vamshin24/bioinspired_grasshopper_jumping_mechanism/docs/notebooks/kinematics.pdf

Group 8 Project Assignment 1 | 14

## Kinematic Model

Jacobian Calculations 4 Bar JupyterLab

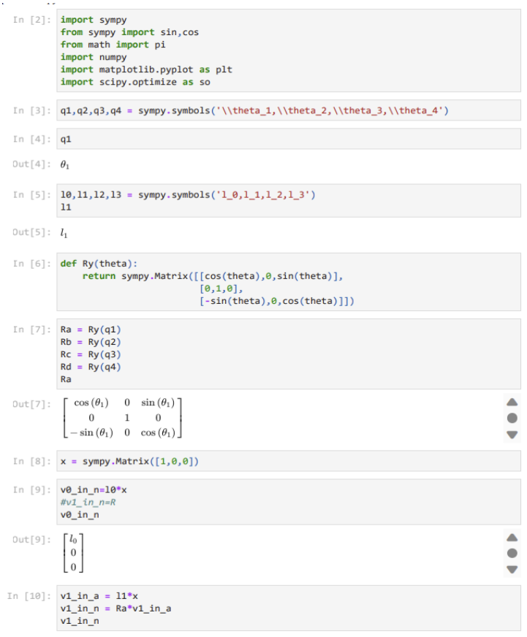
[picture p34: figure]
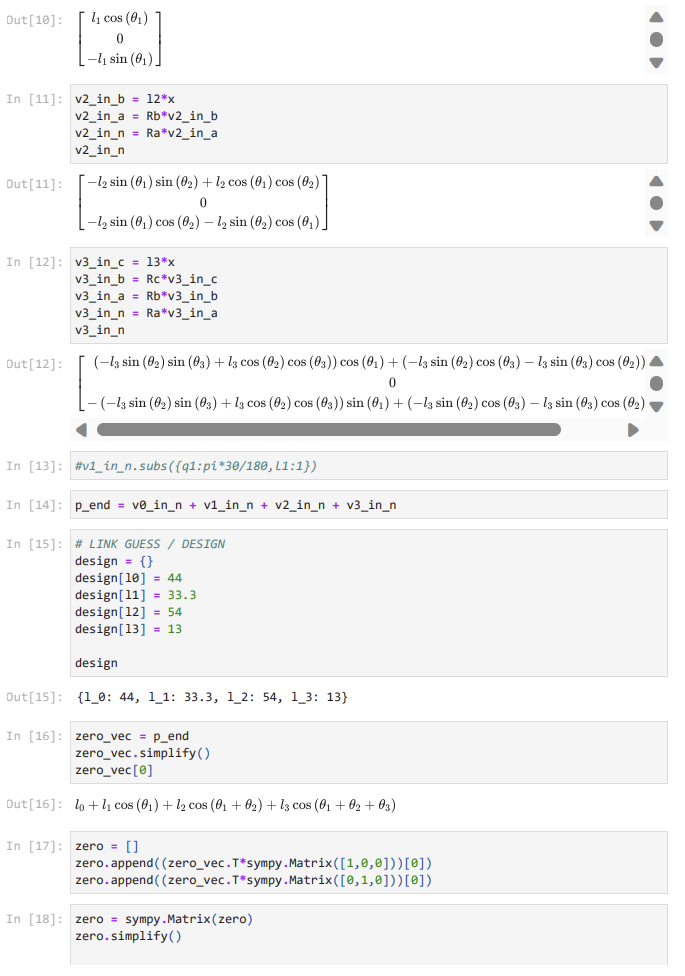
[picture p35: page 2]
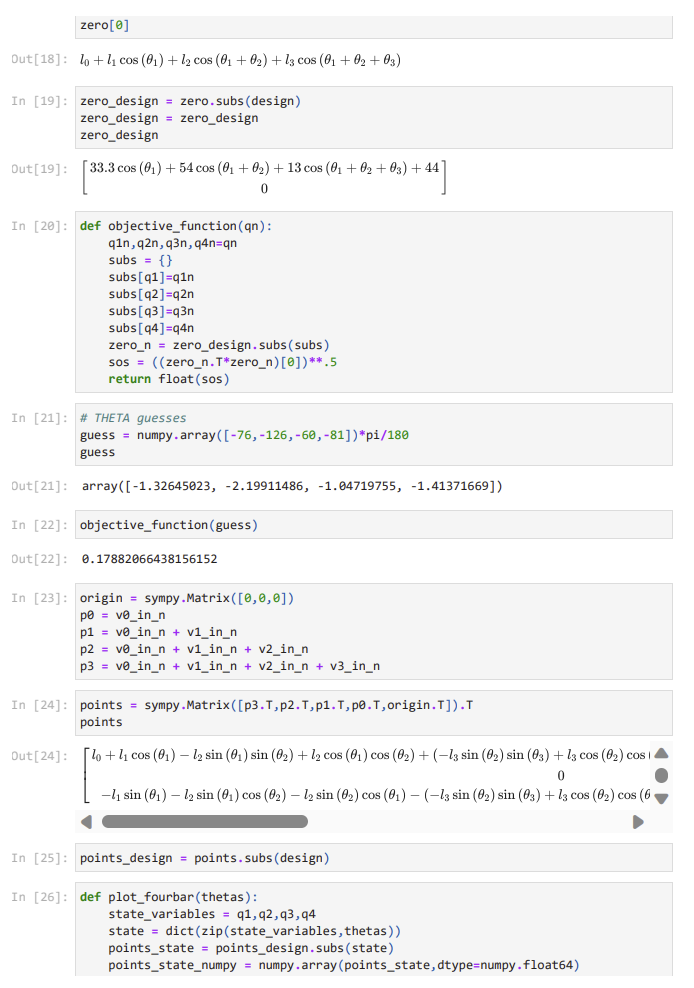
[picture p36: page 3]
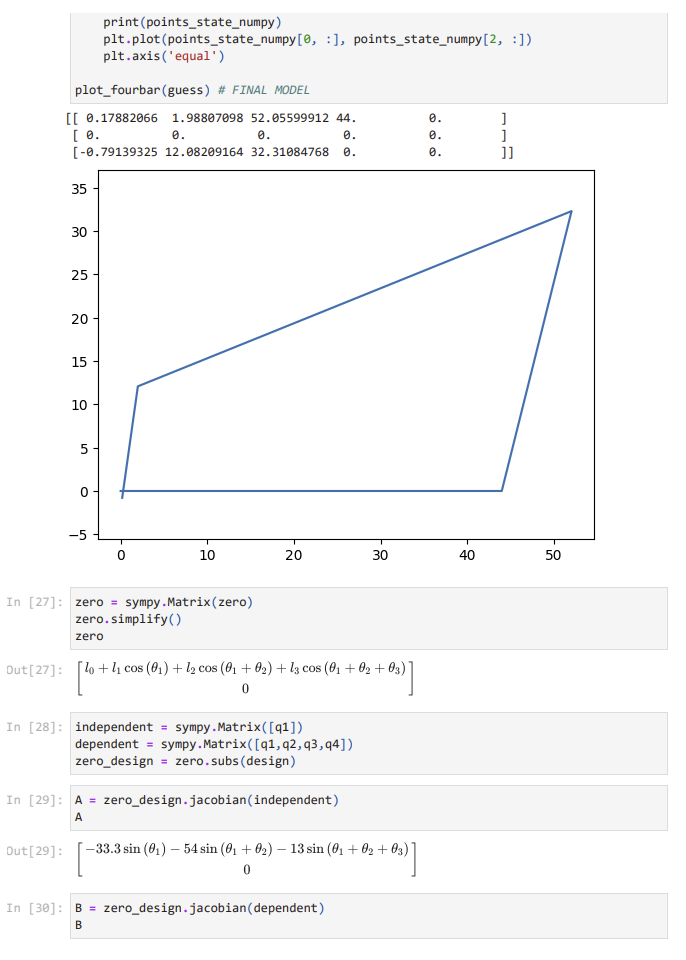
[picture p37: page 4]
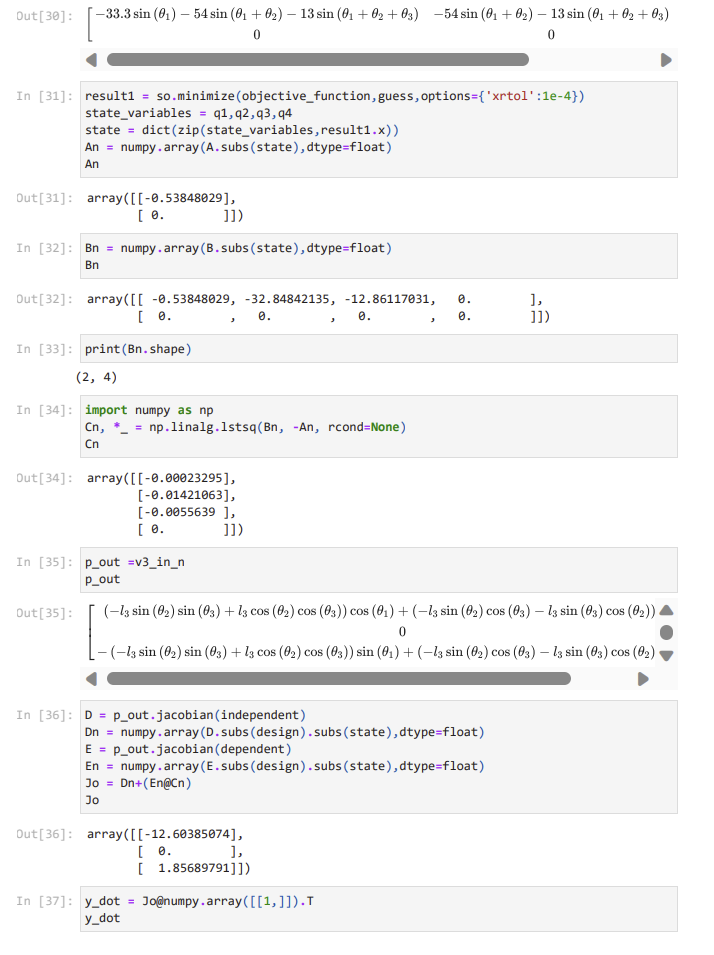
[picture p38: page 5]
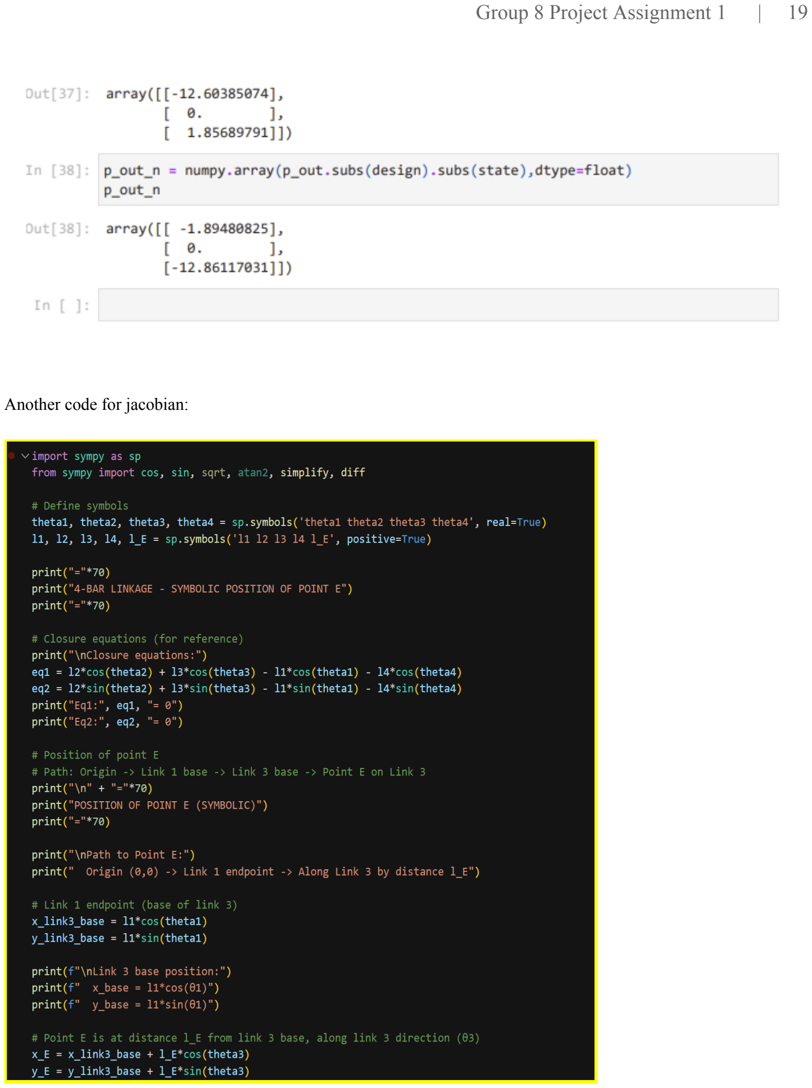
[picture p39: page 6]

Another code for jacobian:

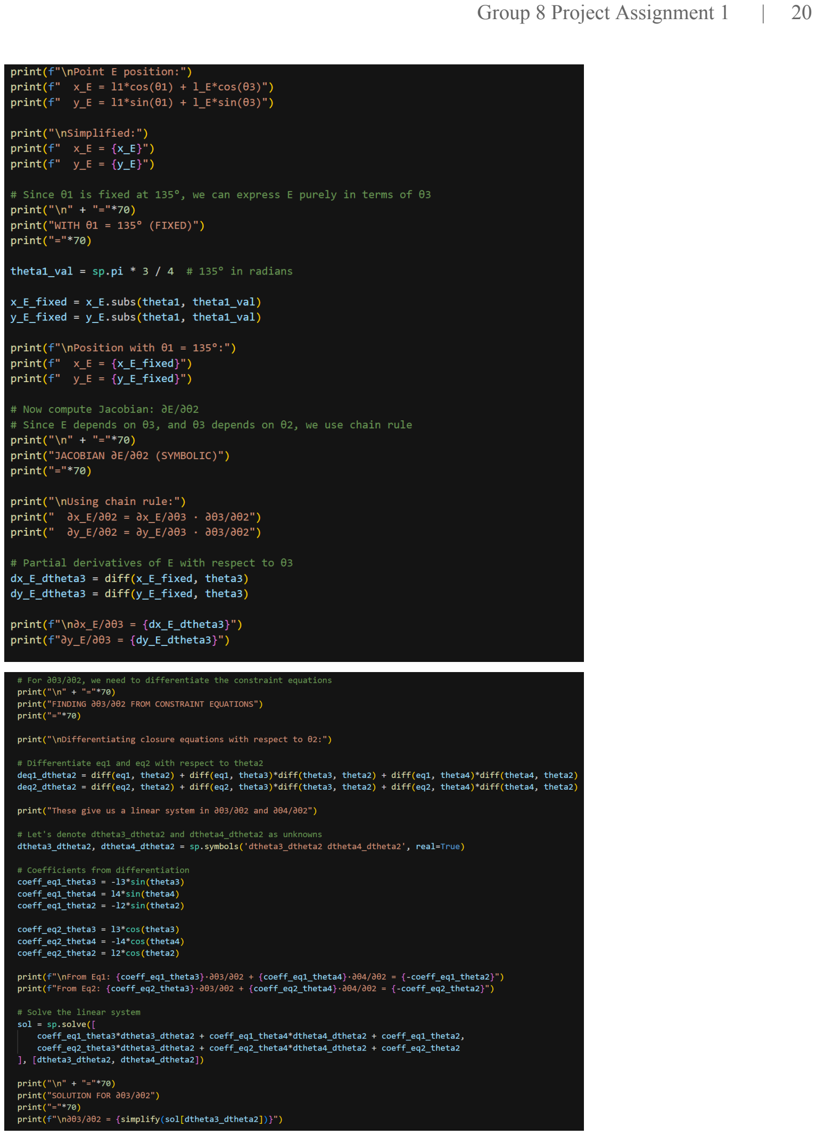
[picture p40: page 7]
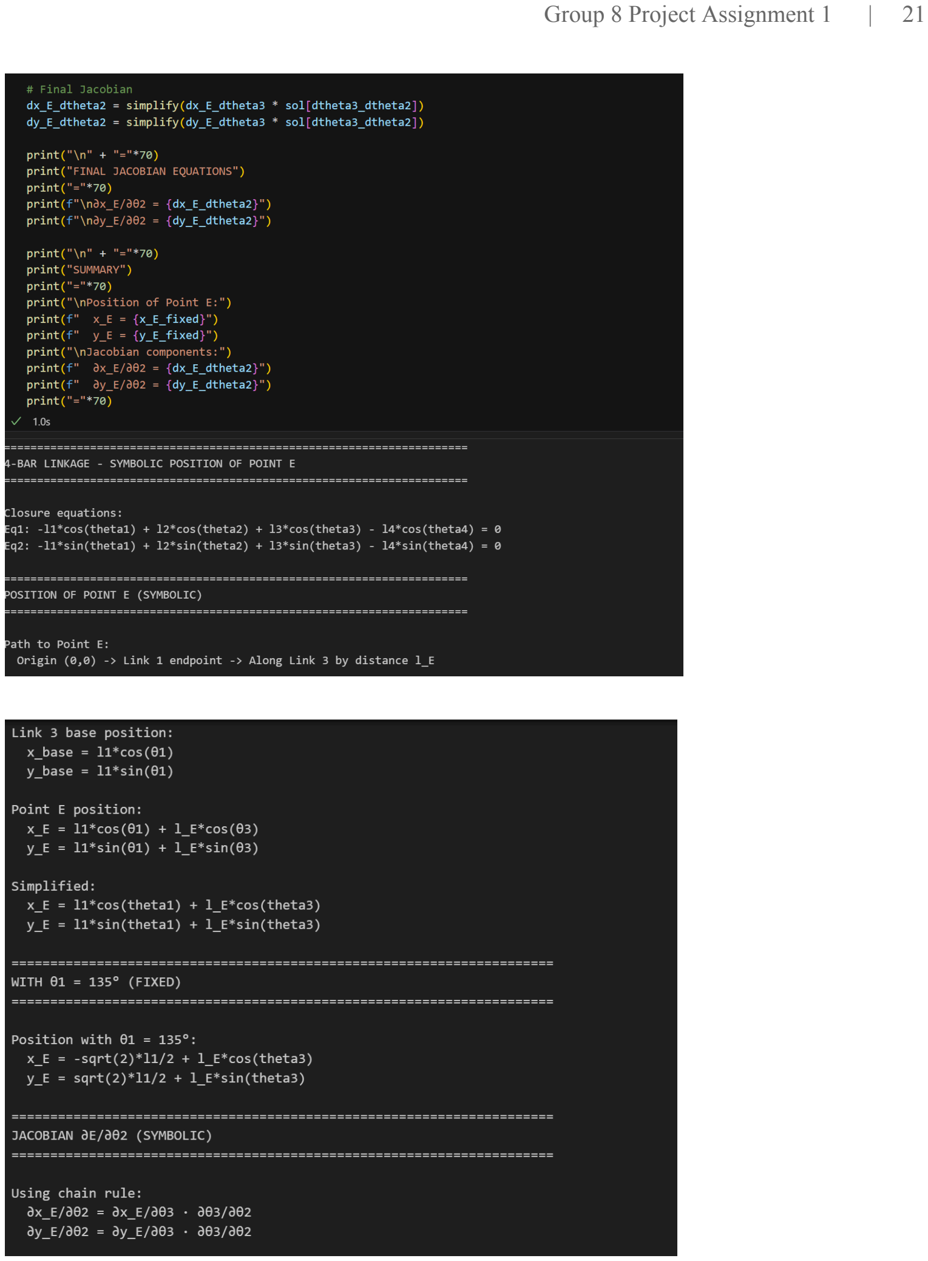
[picture p41: page 8]
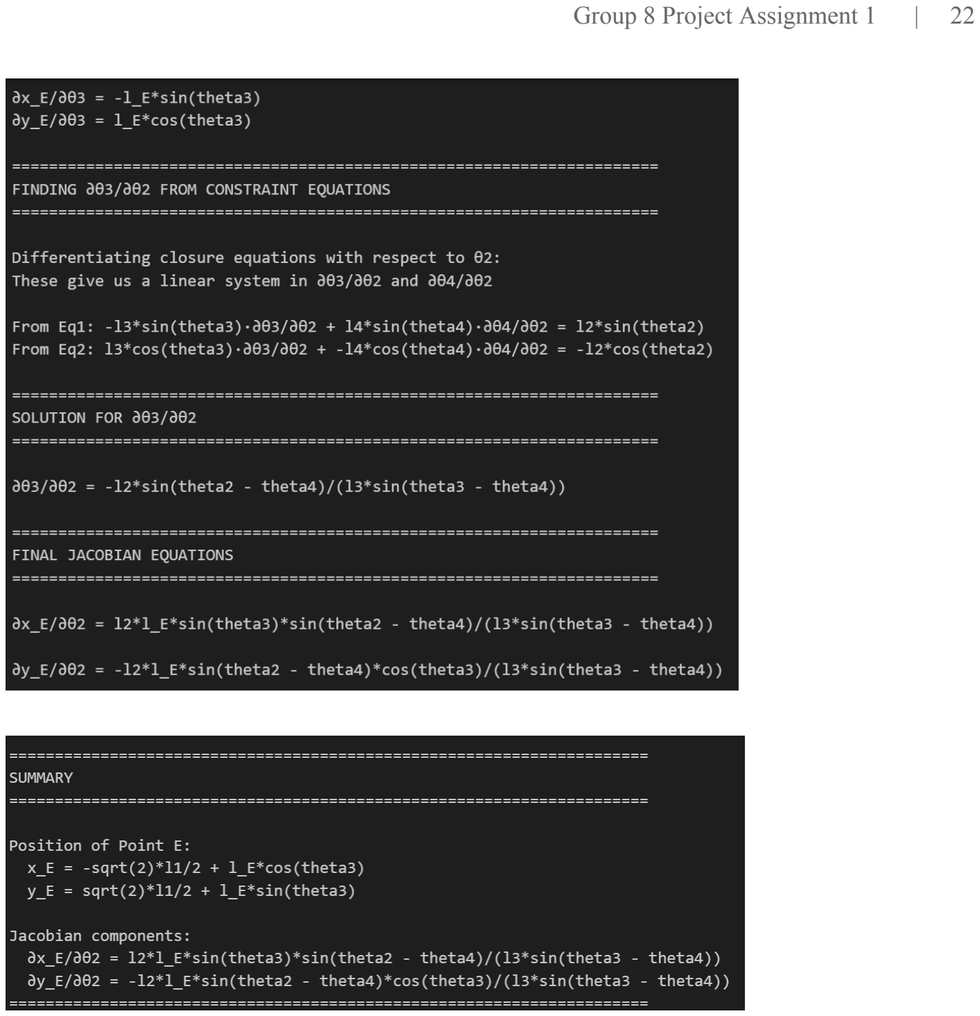
[picture p42: page 9]
