vamshin24/bioinspired_grasshopper_jumping_mechanism/docs/notebooks/grass_body/grass_body.md

pip install foldable_robotics

```python
pip install pycairo
```

    Requirement already satisfied: pycairo in c:\users\shawn\anaconda3\envs\mujoco\lib\site-packages (1.28.0)
    Note: you may need to restart the kernel to use updated packages.

```python
import foldable_robotics.dxf as frd
import foldable_robotics as fr
import foldable_robotics.manufacturing as frm
from foldable_robotics.layer import Layer
from foldable_robotics.laminate import Laminate
import foldable_robotics.parts.castellated_hinge2 as frc
import shapely.geometry as sg
fr.display_height=300
```

```python
fr.resolution = 4
```

```python
desired_degrees = 120
thickness = 1
plain_width = frm.plain_hinge_width(desired_degrees,thickness)
plain_width
```

    1.7320508075688774

```python
support_width = 2 # must be larger than hinge width
kerf = .05
is_adhesive = [False,True,False,True,False]
arc_approx = 10
NUM_LAYERS = 5
bridge_thickness = 1
bounding_box_padding = 10
jig_spacing = 10
jig_dia = 5
body_vertices = frd.read_lwpolylines('grass_body.dxf',
layer='body',
arc_approx = arc_approx)
body_vertices
```

    [[[4.766956363928312, 54.93657673278085],
      [194.7669563639283, 54.93657673278085],
      [194.7669563639283, 89.93657673278085],
      [4.766956363928314, 89.93657673278085],
      [4.766956363928312, 54.93657673278085]]]

```python
body_polygons = [sg.Polygon(item) for item in body_vertices]
body_polygons[0]
```

svg

```python
body_layer = Layer(*body_polygons)
body_layer
```

svg

```python
hole_vertices = frd.read_lwpolylines('grass_body.dxf',
layer='holes',
arc_approx = arc_approx)
hole_layer = Layer(*[sg.Polygon(item) for item in hole_vertices])
hole_layer
```

svg

```python
body_layer -= hole_layer
body_layer

```

svg

```python
cut_vertices = frd.read_lwpolylines('grass_body.dxf',
layer='cuts',
arc_approx = arc_approx)
cut_layer = Layer(*[sg.LineString(item) for item in cut_vertices])
cut_layer
cut_layer <<=.5
cut_layer
body_layer -= cut_layer
body_layer
```

svg

```python
joint_vertices = frd.read_lines('grass_body.dxf', layer='joints')
joint_vertices
```

    [[[23.76695636392832, 89.93657673278085],
      [23.76695636392832, 54.93657673278085]],
     [[47.76695636392832, 89.93657673278085],
      [47.76695636392832, 54.93657673278085]],
     [[61.76695636392832, 89.93657673278085],
      [61.76695636392832, 54.93657673278085]],
     [[101.7669563639283, 89.93657673278085],
      [101.7669563639283, 54.93657673278085]],
     [[165.7669563639283, 89.93657673278085],
      [165.7669563639283, 54.93657673278085]],
     [[179.7669563639283, 89.93657673278085],
      [179.7669563639283, 54.93657673278085]],
     [[189.7669563639283, 89.93657673278085],
      [189.7669563639283, 54.93657673278085]],
     [[115.7669563639283, 89.93657673278085],
      [115.7669563639283, 54.93657673278085]],
     [[9.76696, 89.9366], [9.76696, 54.9366]]]

```python
l = sg.LineString(joint_vertices[0])
l
```

svg

```python
joint_lines_original_layer = Layer(*[sg.LineString(item) for item in joint_vertices])
joint_lines_original_layer
```

svg

```python
body_layer.plot()
joint_lines_original_layer.plot()
```

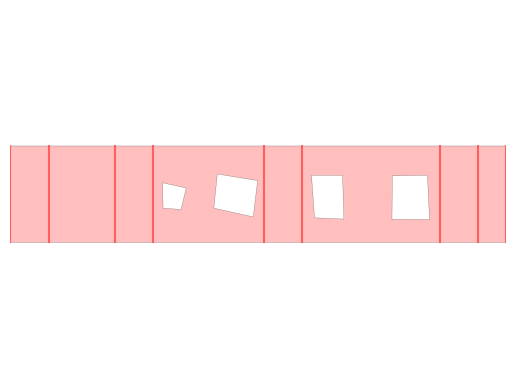
[picture p53: docs/notebooks/grass_body/output_14_0.png]


```python
joint_lines_modified_layer = joint_lines_original_layer & body_layer
body_layer.plot()
joint_lines_modified_layer.plot()
```

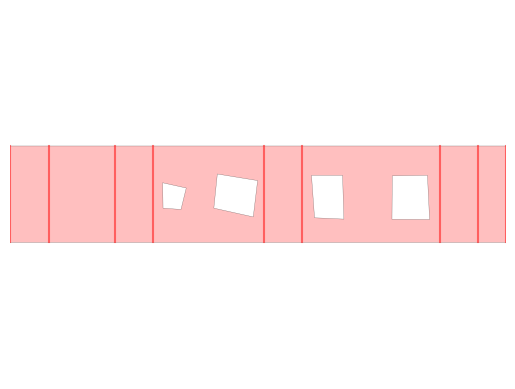
[picture p54: docs/notebooks/grass_body/output_15_0.png]


```python
modified_joint_vertices = [list(item.coords) for item in joint_lines_modified_layer.geoms]
modified_joint_vertices

```

    [[(23.76695636392832, 89.93657673278085),
      (23.76695636392832, 54.93657673278085)],
     [(47.76695636392832, 89.93657673278085),
      (47.76695636392832, 54.93657673278085)],
     [(61.76695636392832, 89.93657673278085),
      (61.76695636392832, 54.93657673278085)],
     [(101.7669563639283, 89.93657673278085),
      (101.7669563639283, 54.93657673278085)],
     [(165.7669563639283, 89.93657673278085),
      (165.7669563639283, 54.93657673278085)],
     [(179.7669563639283, 89.93657673278085),
      (179.7669563639283, 54.93657673278085)],
     [(189.7669563639283, 89.93657673278085),
      (189.7669563639283, 54.93657673278085)],
     [(115.7669563639283, 89.93657673278085),
      (115.7669563639283, 54.93657673278085)],
     [(9.76696, 89.93657673278085), (9.76696, 54.9366)]]

```python
simple_joint_layer = joint_lines_modified_layer << plain_width/2
simple_joint_layer

```

svg

```python
hole,dummy = frm.calc_hole(modified_joint_vertices,plain_width/2)
fr.my_line_width=0
holes = hole.to_laminate(NUM_LAYERS)
holes<<=.5 # add a little extra material to ensure we removed enough.
holes

```

svg

    <Figure size 640x480 with 0 Axes>

```python
rigid_layer = (body_layer - simple_joint_layer)
rigid_layer
```

svg

```python
adhesive_layer = rigid_layer & body_layer
adhesive_layer
```

svg

```python
ideal_final_device = Laminate(rigid_layer,adhesive_layer, body_layer,
adhesive_layer,rigid_layer)
ideal_final_device

```

svg

```python
ideal_final_device[0]

```

svg

```python
ideal_final_device[2]

```

svg

```python
bridges = frd.read_lines('grass_body.dxf', layer='bridge')
bridges
bridges_layer = Layer(*[sg.LineString(item) for item in bridges])
bridges_layer <<= bridge_thickness
bridges_layer
```

svg

```python
bridges_lam = Laminate(bridges_layer,bridges_layer,Layer(),bridges_layer,bridges_layer)
bridges_lam

```

svg

```python
supported_actual_device = ideal_final_device | bridges_lam
supported_actual_device

```

svg

```python
diff = supported_actual_device - ideal_final_device
removal = frm.cleanup(diff, .1)
removal
```

svg

```python
removal = frm.keepout_laser(removal)
removal
```

svg

```python
actual_final_device = ideal_final_device- holes - removal
actual_final_device

```

svg

```python
keepout = frm.keepout_laser(actual_final_device)
keepout

```

svg

```python
layer_id = frm.build_layer_numbers(NUM_LAYERS,
text_size=jig_dia)
layer_id = layer_id.simplify(.2)
layer_id[0]

```

svg

```python
(x1,y1),(x2,y2) = actual_final_device.bounding_box_coords()
w1,h1 = actual_final_device.get_dimensions()
w2 = round(w1/jig_spacing)*jig_spacing+jig_spacing+support_width
h2 = round(h1/jig_spacing)*jig_spacing+jig_spacing+support_width
x1 -= (w2-w1)/2
y1 -= (h2-h1)/2
x2 += (w2-w1)/2
y2 += (h2-h1)/2
points = []
points.append(sg.Point(x1,y1))
points.append(sg.Point(x2,y1))
points.append(sg.Point(x1,y2))
points.append(sg.Point(x2,y2))
alignment_holes_layer = Layer(*points)
alignment_holes_layer<<=(jig_dia/2)
alignment_holes=alignment_holes_layer.to_laminate(NUM_LAYERS)
alignment_holes

```

svg

```python
sheet_layer = (alignment_holes_layer<<bounding_box_padding).bounding_box()
sheet=sheet_layer.to_laminate(NUM_LAYERS)
sheet

```

svg

```python
removable_scrap = frm.calculate_removable_scrap(
actual_final_device,sheet,support_width,is_adhesive)
web = removable_scrap-alignment_holes-layer_id.translate(x1+jig_dia,y1-jig_dia/2)
web

```

svg

```python
(web|actual_final_device)

```

svg

```python
second_pass_scrap = sheet-keepout
second_pass_scrap
```

svg

```python
first_pass_scrap = sheet - second_pass_scrap - actual_final_device
first_pass_scrap = frm.cleanup(first_pass_scrap,.00001)
first_pass_scrap

```

svg

```python
support = frm.support(actual_final_device,
frm.keepout_laser,support_width,support_width/2)
support

```

svg

```python
support | bridges_lam

```

svg

```python
supported_design = web|actual_final_device|support| bridges_lam
supported_design

```

svg

```python
cut_material = (keepout<<kerf)-keepout
cut_material

```

svg

```python
remaining_material = supported_design-cut_material
remaining_material

```

svg

```python
remaining_parts = frm.find_connected(remaining_material,is_adhesive)
for item in remaining_parts:
    item.plot(new=True)

```

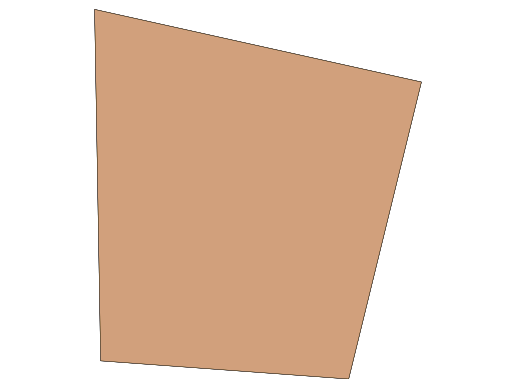
[picture p55: docs/notebooks/grass_body/output_43_0.png]


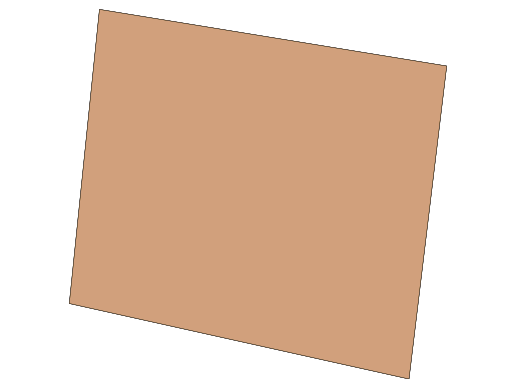
[picture p56: docs/notebooks/grass_body/output_43_1.png]


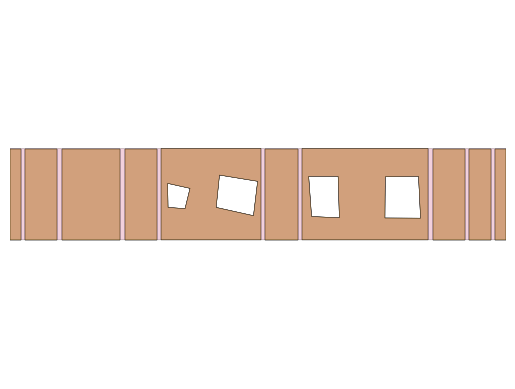
[picture p57: docs/notebooks/grass_body/output_43_2.png]


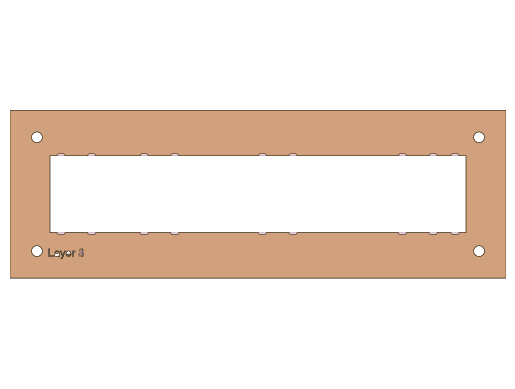
[picture p58: docs/notebooks/grass_body/output_43_3.png]


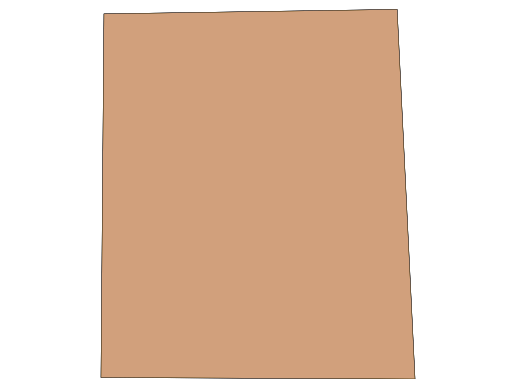
[picture p59: docs/notebooks/grass_body/output_43_4.png]


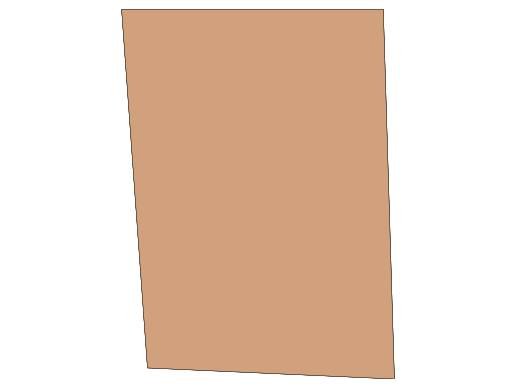
[picture p60: docs/notebooks/grass_body/output_43_5.png]


```python
test_part=actual_final_device>>1
for result in remaining_parts:
    if not (result&test_part).is_null():
        break
result
```

svg

```python
check = (result^actual_final_device)
check>>=1e-1
assert(check.is_null())
```

```python
w,h = supported_design.get_dimensions()
p0,p1 = supported_design.bounding_box_coords()
rigid_layer = supported_design[0] | (supported_design[-1].translate(w+5,0))
rigid_layer
```

svg

```python
l4 = supported_design[3].scale(-1,1)
p2,p3 = l4.bounding_box_coords()
l4 = l4.translate(p0[0]-p2[0]+w+5,p0[1]-p2[1])
adhesive_layer = supported_design[1] | l4
adhesive_layer

```

svg

```python
first_pass = Laminate(rigid_layer,adhesive_layer,supported_design[2])
first_pass.export_dxf('first_pass_body')

```

```python
final_cut = sheet - keepout
final_cut = final_cut[0]
final_cut.export_dxf('final_cut_body')
final_cut

```

svg

```python
from foldable_robotics.pdf import Page
import foldable_robotics.pdf as frp

```

```python
# === 2-row grid with mirrored pairs + final_cut in top-right ===
# Configure which laminate layers to use
TOP_IDX = 4        # <- pick the "different" layer number for the NEW TOP row
BOTTOM_IDX = 3     # <- your current layer number for the BOTTOM row

S = frp.ppi / 25.4     # mm -> PDF points
PAD = 30               # page margins (pt)
GAP_X, GAP_Y = 60, 80  # spacing between cells (pt)
CELL_PAD = 12          # inner padding in each cell (pt)

def as_layer(obj):
    # Accept a Layer or Laminate; return a Layer (first layer if Laminate) 
    return obj if hasattr(obj, "get_paths") else obj.layers[0]

def normalize(layer):
    # Scale to points and move bottom-left to (0,0)
    L = layer.scale(S, S)
    (x0, y0), _ = L.bounding_box_coords()
    return L.translate(-x0, -y0)

def mirror_h(layer):
    # Mirror horizontally about the layer's own center
    (a, b) = layer.bounding_box_coords()
    cx = (a[0] + b[0]) / 2
    return layer.translate(-cx, 0).scale(-1, 1).translate(cx, 0)

def size(layer):
    (a, b) = layer.bounding_box_coords()
    return (b[0] - a[0], b[1] - a[1])

def scale_to_fit(layer, w, h, pad=CELL_PAD):
    lw, lh = size(layer)
    if lw == 0 or lh == 0: 
        return layer
    k = min((w - pad)/lw, (h - pad)/lh, 1.0)
    return layer.scale(k, k)

def draw(page, obj):
    # Draw a Layer or Laminate
    layers = getattr(obj, "layers", [obj])
    for lyr in layers:
        for path in lyr.get_paths():
            page.draw_poly(path)

# --- build the six cells (2 rows × 3 cols) ---
# top row: [ left_pair(original @ TOP_IDX), mirrored(TOP_IDX), final_cut ]
# bottom row: [ left_pair(original @ BOTTOM_IDX), mirrored(BOTTOM_IDX), (empty) ]

top_left  = normalize(as_layer(supported_design[TOP_IDX]))
top_right = mirror_h(top_left)

bot_left  = normalize(as_layer(supported_design[BOTTOM_IDX]))
bot_right = mirror_h(bot_left)

final_layer = normalize(as_layer(final_cut))   # final_cut already a Layer in your notebook

# Estimate a reasonable cell size from the largest item
max_w = max(size(L)[0] for L in [top_left, top_right, bot_left, bot_right, final_layer])
max_h = max(size(L)[1] for L in [top_left, top_right, bot_left, bot_right, final_layer])
CELL_W = max_w + 80
CELL_H = max_h + 80

# Page size (2 rows × 3 cols)
page_w = PAD + 3*CELL_W + 2*GAP_X + PAD
page_h = PAD + 2*CELL_H + GAP_Y + PAD

p = Page('grass_plus__body_final.pdf', height=page_h)

def place(layer, row, col):
    # fit to cell and center within that cell
    Lf = scale_to_fit(layer, CELL_W, CELL_H)
    (a, b) = Lf.bounding_box_coords()
    lw, lh = size(Lf)
    x0 = PAD + col*(CELL_W + GAP_X)
    y0 = page_h - PAD - (row+1)*CELL_H - row*GAP_Y  # rows from top
    dx = x0 + (CELL_W - lw)/2 - a[0]
    dy = y0 + (CELL_H - lh)/2 - a[1]
    draw(p, Lf.translate(dx, dy))

# Top row (row 0)
place(top_left,  0, 0)
place(top_right, 0, 1)
place(final_layer, 0, 2)

# Bottom row (row 1)
place(bot_left,  1, 0)
place(bot_right, 1, 1)
# leave (row 1, col 2) empty, or duplicate final_layer there if you like:
# place(final_layer, 1, 2)

p.close()
print("✅ Exported: grass_two_rows_plus_final.pdf")
```

    ✅ Exported: grass_two_rows_plus_final.pdf
