vamshin24/bioinspired_grasshopper_jumping_mechanism/docs/assets/Final_graph.png

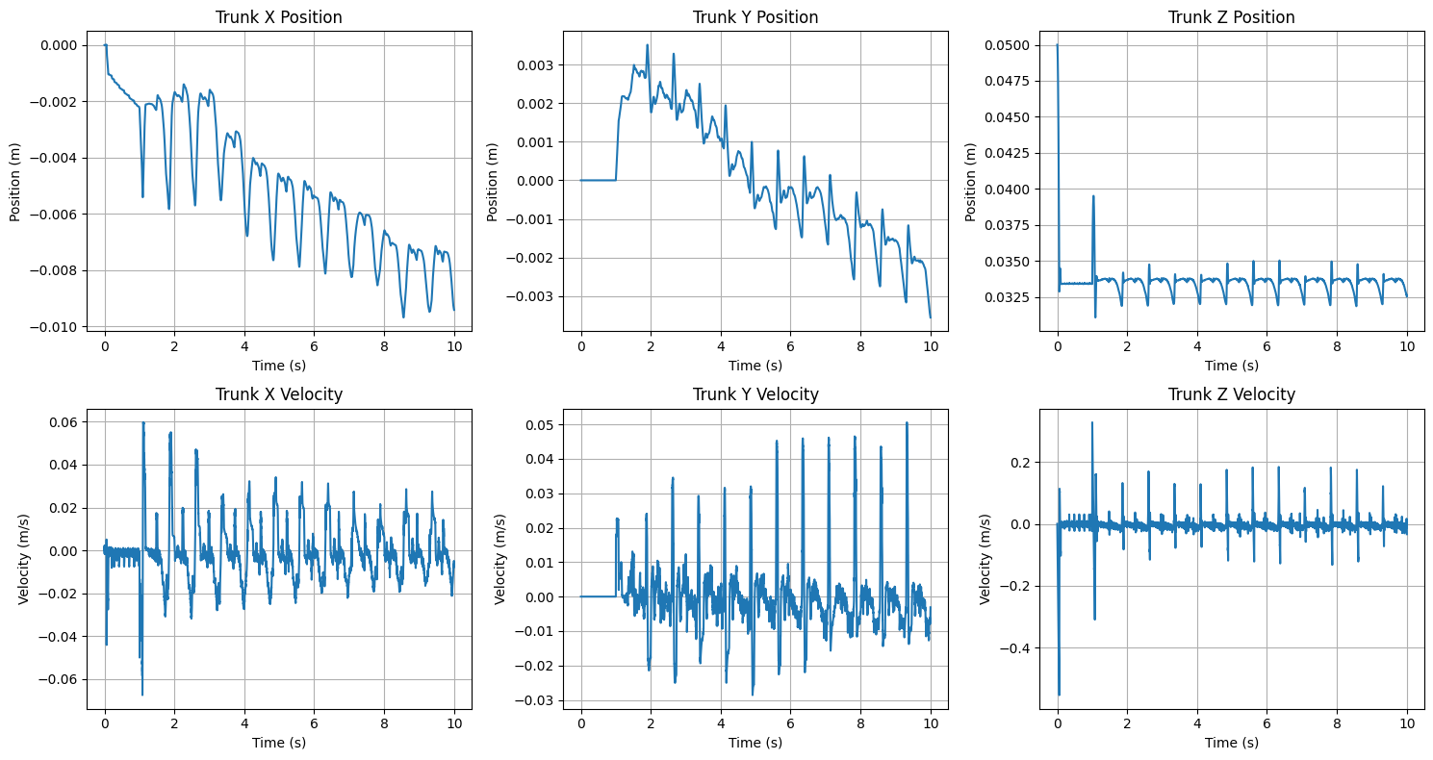
docs/assets/Final_graph.png
