vamshin24/bioinspired_grasshopper_jumping_mechanism/docs/assets/Screenshot 2025-12-08 at 23.02.04.png

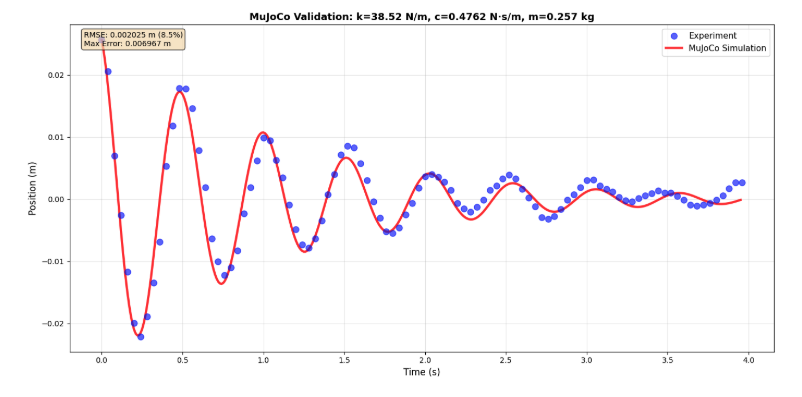
docs/assets/Screenshot 2025-12-08 at 23.02.04.png
