vamshin24/bioinspired_grasshopper_jumping_mechanism/docs/assets/ss4.png

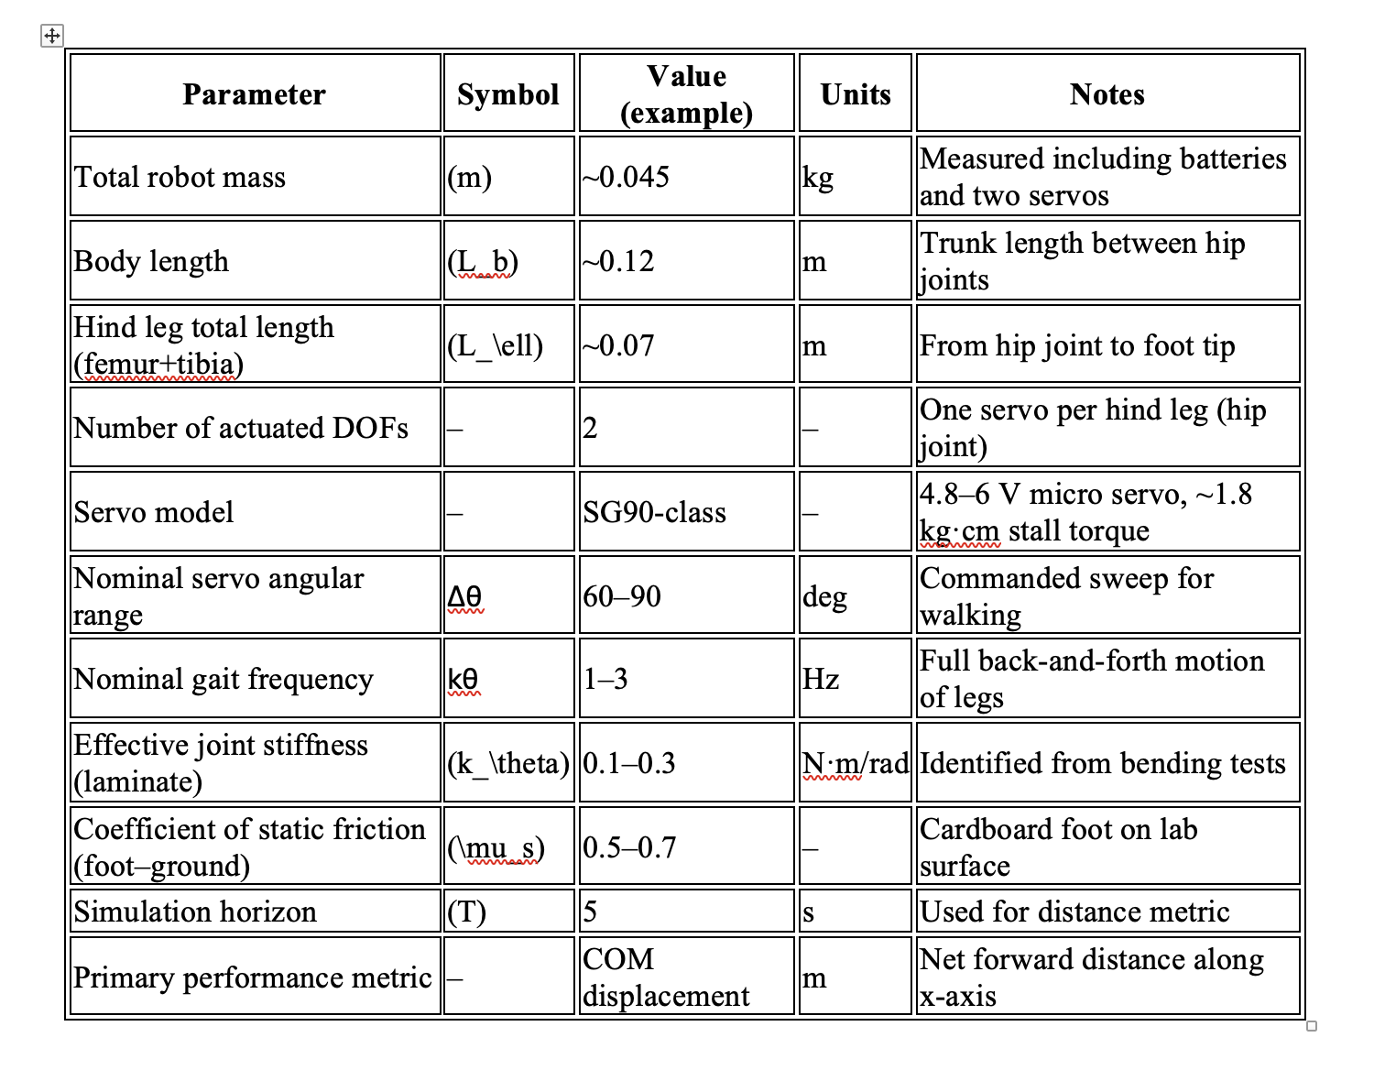
docs/assets/ss4.png
