vamshin24/bioinspired_grasshopper_jumping_mechanism/docs/notebooks/Assignment5_RAS557/image.png

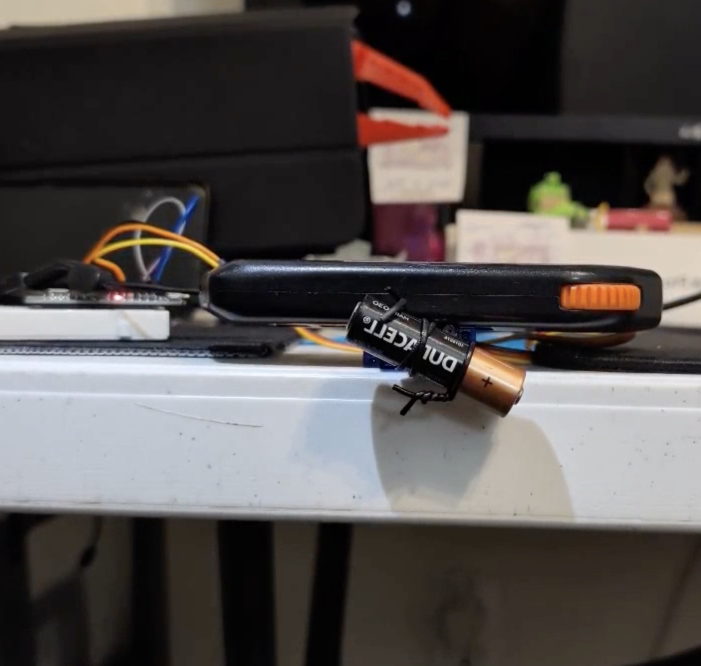
docs/notebooks/Assignment5_RAS557/image.png
