vamshin24/bioinspired_grasshopper_jumping_mechanism/docs/notebooks/Assignment5_RAS557/output_26_1.png

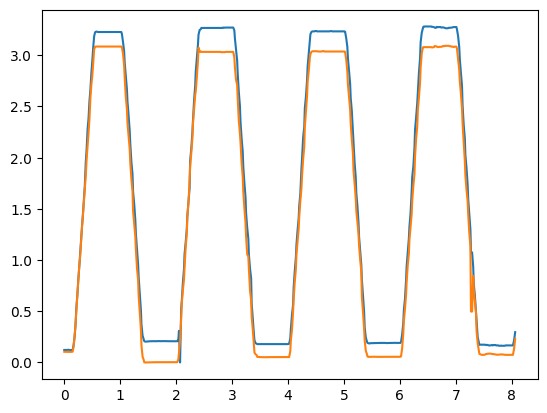
docs/notebooks/Assignment5_RAS557/output_26_1.png
