vamshin24/bioinspired_grasshopper_jumping_mechanism/docs/notebooks/RAS557_Assignment6_1234232638/output_18_0.png

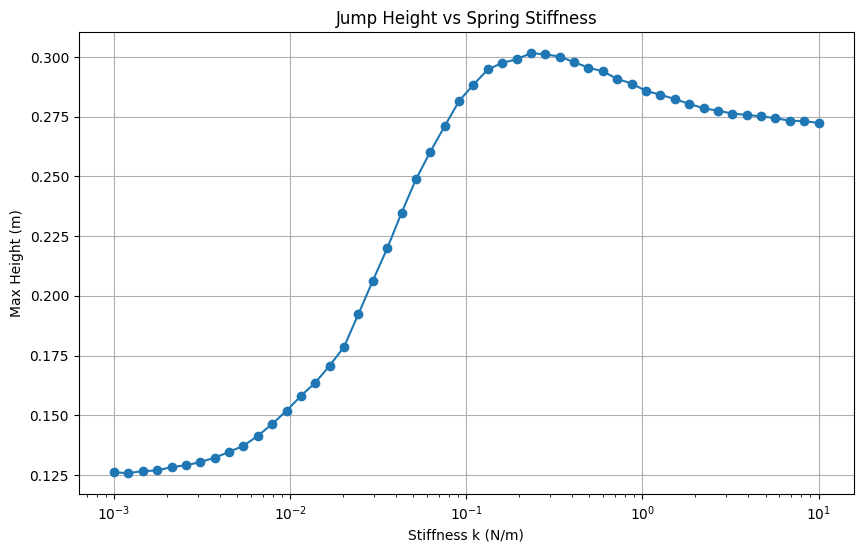
docs/notebooks/RAS557_Assignment6_1234232638/output_18_0.png
