vamshin24/bioinspired_grasshopper_jumping_mechanism/docs/notebooks/RAS557_Assignment6_1234232638/output_20_1.png

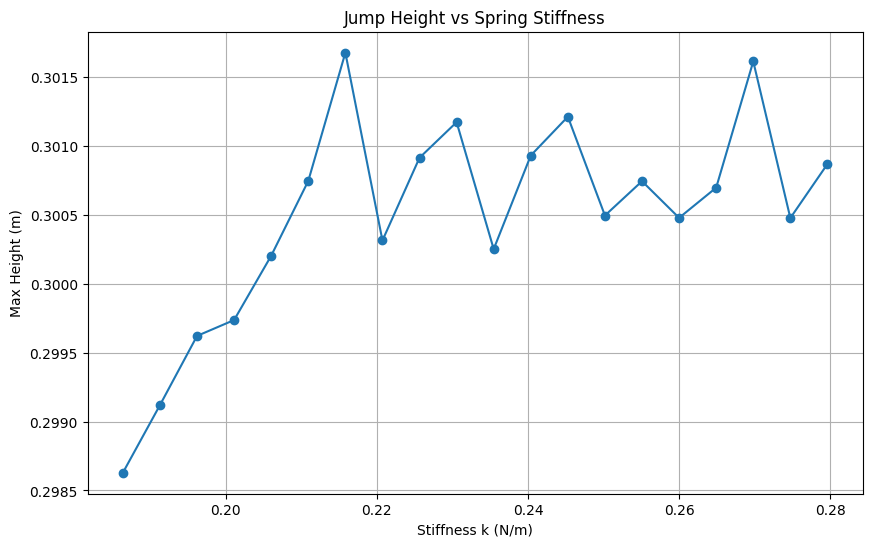
docs/notebooks/RAS557_Assignment6_1234232638/output_20_1.png
