vamshin24/bioinspired_grasshopper_jumping_mechanism/docs/notebooks/Sameer_Hopper_File/output_4_2.png

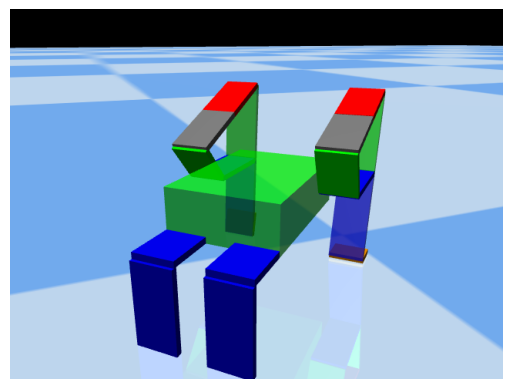
docs/notebooks/Sameer_Hopper_File/output_4_2.png
