vamshin24/bioinspired_grasshopper_jumping_mechanism/docs/assets/dxf/final_cut.dxf

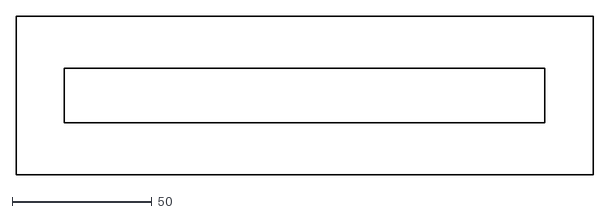
[picture p83: CAD file, 2025-12-09]
docs/assets/dxf/final_cut.dxf
206.6 x 56.6
