vamshin24/bioinspired_grasshopper_jumping_mechanism/docs/assets/dxf/first_pass2.dxf

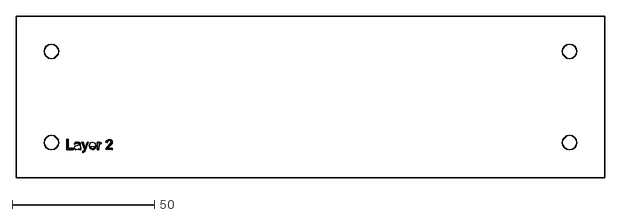
[picture p84: CAD file, 2025-12-09]
docs/assets/dxf/first_pass2.dxf
206.6 x 56.6
