vamshin24/bioinspired_grasshopper_jumping_mechanism/docs/assets/dxf/first_pass_body1.dxf

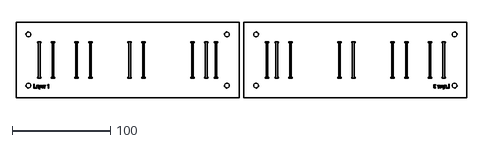
[picture p85: CAD file, 2025-12-09]
docs/assets/dxf/first_pass_body1.dxf
458.2 x 76.6
