vamshin24/bioinspired_grasshopper_jumping_mechanism/docs/assets/dxf/first_pass1.dxf

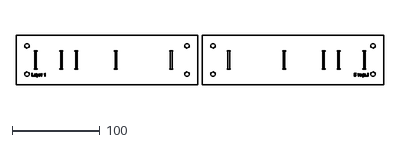
[picture p86: CAD file, 2025-12-09]
docs/assets/dxf/first_pass1.dxf
418.2 x 56.6
