vamshin24/bioinspired_grasshopper_jumping_mechanism/docs/assets/dxf/first_pass_body2.dxf

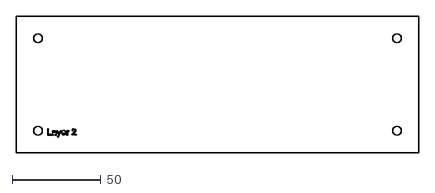
[picture p87: CAD file, 2025-12-09]
docs/assets/dxf/first_pass_body2.dxf
226.6 x 76.6
