vamshin24/bioinspired_grasshopper_jumping_mechanism/docs/assets/dxf/first_pass0.dxf

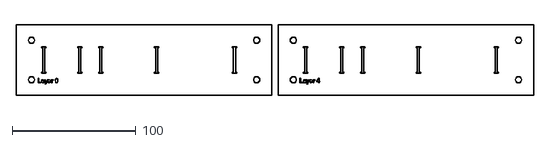
[picture p88: CAD file, 2025-12-09]
docs/assets/dxf/first_pass0.dxf
418.2 x 56.6
