vamshin24/bioinspired_grasshopper_jumping_mechanism/docs/assets/dxf/#final_cut_body.dxf

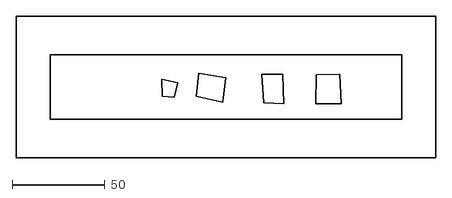
[picture p89: CAD file, 2025-12-09]
docs/assets/dxf/#final_cut_body.dxf
226.6 x 76.6
