vamshin24/bioinspired_grasshopper_jumping_mechanism/(list of files, cad)

Other CAD files:
docs/assets/dxf/final_cut_body.dxf
